motabablu/tt-pio-core/src/timing_controller.sv

`timescale 1ns / 1ps
`default_nettype none

module TIMING_CTRL (
  input  logic        CLK_i,
  input  logic        RESET_n_i,
  input  logic        DELAY_EN_i,
  input  logic [7:0]  DELAY_VAL_i,
  input  logic        WAIT_EDGE_EN_i,
  input  logic [3:0]  EDGE_PIN_i,
  input  logic        EDGE_POLARITY_i,
  input  logic [15:0] PIN_IN_i,
  output logic        STALL_o
);

  logic [7:0]  delay_counter;
  logic [15:0] pin_in_prev;
  
  logic edge_detected;
  logic active_delay;

  always_comb begin
    edge_detected = 1'b0;
    if (EDGE_POLARITY_i == 1'b1) begin
      edge_detected = (~pin_in_prev[EDGE_PIN_i]) & PIN_IN_i[EDGE_PIN_i];
    end else begin
      edge_detected = pin_in_prev[EDGE_PIN_i] & (~PIN_IN_i[EDGE_PIN_i]);
    end
  end

  always_comb begin
    STALL_o = 1'b0;
    if (DELAY_EN_i && (DELAY_VAL_i > 0)) begin
      if (!active_delay) begin
        STALL_o = (DELAY_VAL_i > 1);
      end else begin
        STALL_o = (delay_counter > 1);
      end
    end else if (WAIT_EDGE_EN_i) begin
      STALL_o = ~edge_detected;
    end
  end

  always_ff @(posedge CLK_i or negedge RESET_n_i) begin
    if (!RESET_n_i) begin
      delay_counter <= '0;
      pin_in_prev   <= '0;
      active_delay  <= 1'b0;
    end else begin
      pin_in_prev <= PIN_IN_i;

      if (DELAY_EN_i && (DELAY_VAL_i > 1)) begin
        if (!active_delay) begin
          active_delay  <= 1'b1;
          delay_counter <= DELAY_VAL_i - 1'b1;
        end else if (delay_counter > 1) begin
          delay_counter <= delay_counter - 1'b1;
        end else begin
          active_delay  <= 1'b0;
          delay_counter <= '0;
        end
      end else begin
        active_delay  <= 1'b0;
        delay_counter <= '0;
      end
    end
  end

endmodule
