motabablu/tt-pio-core/(commit log)

2026-10-28 Lowered FIFO depth and removed test flow
2026-10-28 Replaced SRAM blackbox for sim
    [dp_sram.sv, fifo.sv, test.py]
2026-10-28 Fixed race condition in tb
    [test.py]
2026-10-28 Fixed padding in test.py
    [test.py]
2026-10-28 Fixed width mismatch leading to LVS errors
    [dp_sram.sv]
2026-10-28 Modified dp_sram to prevent floating wire in LVS
    [dp_sram.sv]
2026-10-29 Updated to current CMOS5L
